cryang659/tunnel-bridge-monitor/123_tunnel/docs/资料包/DX-CT02资料包 20251120_02 模块功能应用指导_SIM卡 说明总结.txt

基础说明：1. 卡类型 --- 30M、100M (使用期限 1 年，使用期限到期后需续费才能继续使用)

停机 机制：1. 当月可用流量用完，会自动停机，需要充值 叠加包，或者等到下个月初，才能正常使用
                 2. 当月可用流量最高300M，超过300M 即使充值 叠加包 也会自动停机，需要等到下个月初，才能正常使用
                 3. 检测IMEI 变更 (例如: 已激活的SIM卡插到其他设备上使用)，会自动停机
                 4. 已激活的SIM卡，连续6个月没有上线，会自动转为停机状态

充值/查询：1. 主套餐 ---   同类型套餐，购买会延长使用时间；不同类型套餐，等原套餐使用时间结束后再生效
                  2. 叠加包 ---  增加当月可用流量，到下个月初自动清零；叠加包充值一般立即生效
                  3. SIM卡状态、流量使用的查询结果，可能会有1~2小时的延迟
                  3. 只能在我们公司的服务号上充值或查询，不提供API接口

沉默期/激活：1. 从供应商发卡算起，有至少6个月的沉默期，到期后卡会自动激活
                     2. 沉默期期间，如SIM卡插入设备上电激活，将提前结束沉默期，开始计算使用时间
                     3. 激活按自然月计时，例如：7月29激活 -> 7月视为第1个计时月，有效期至次年6月30

注销：1. 服务有效期为 1 年，到期后如未续费，账号将进入 3 个月的保留期
          2. 保留期结束后仍未续费，SIM卡会自动注销
