cryang659/tunnel-bridge-monitor/123_bridge/docs/资料包/DX-CT02资料包 20251120_02 模块功能应用指导_SIM卡流量操作示例.pdf

## SIM 卡-微信小程序

## 1.1 进入服务号

1. 微信搜索 “大夏龙雀通信专家” ，选择 “拿样攻略” ，点击 “4G 数传流量充值”

## 1.2 流量查询

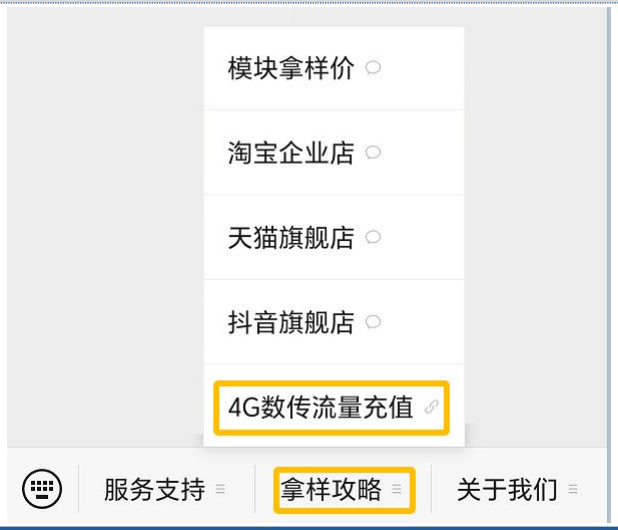
[picture p1: figure]

注：流量查询一般 3h 左右的延迟

## 1. 确认 SIM 卡的 ICCID 号

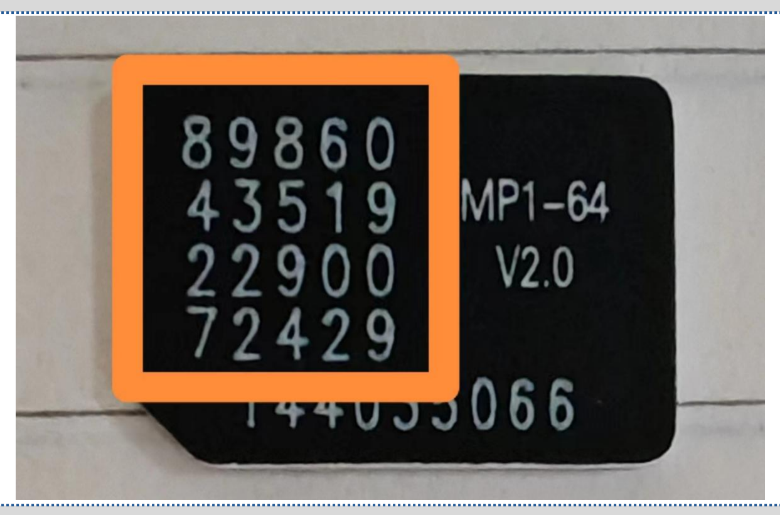
[picture p2: figure]

2. 输入卡号，点击卡号登录：

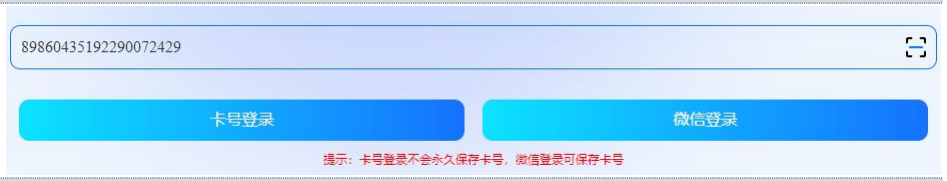
[picture p3: figure]

3. 登录后即可查询流量

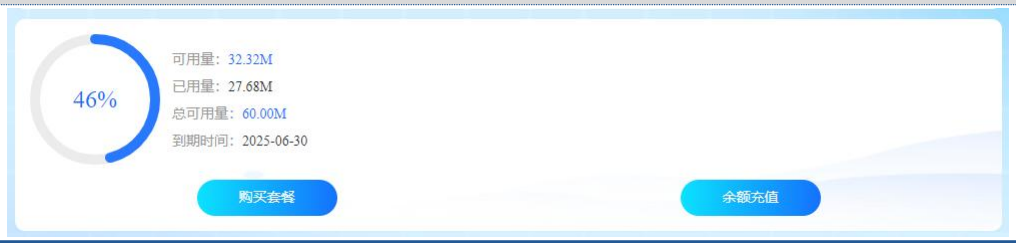
[picture p4: figure]

## 1.3 流量充值

注：充值的叠加包，月末会清零

## 1. 确认 SIM 卡的 ICCID 号

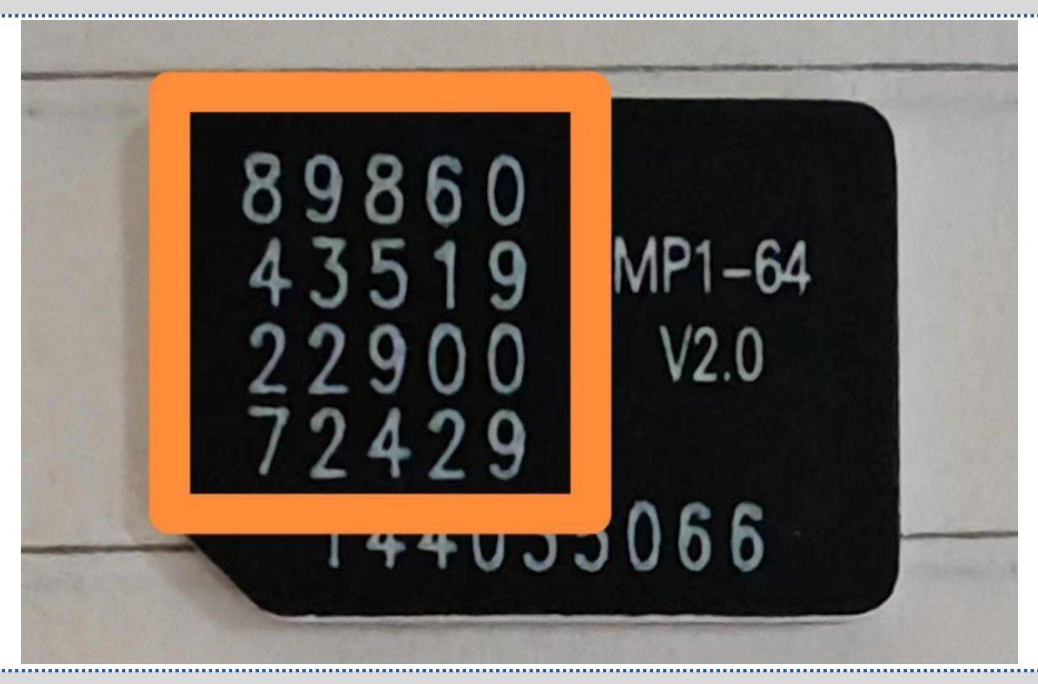
[picture p5: figure]

2. 输入卡号，点击卡号登录，选择购买套餐：

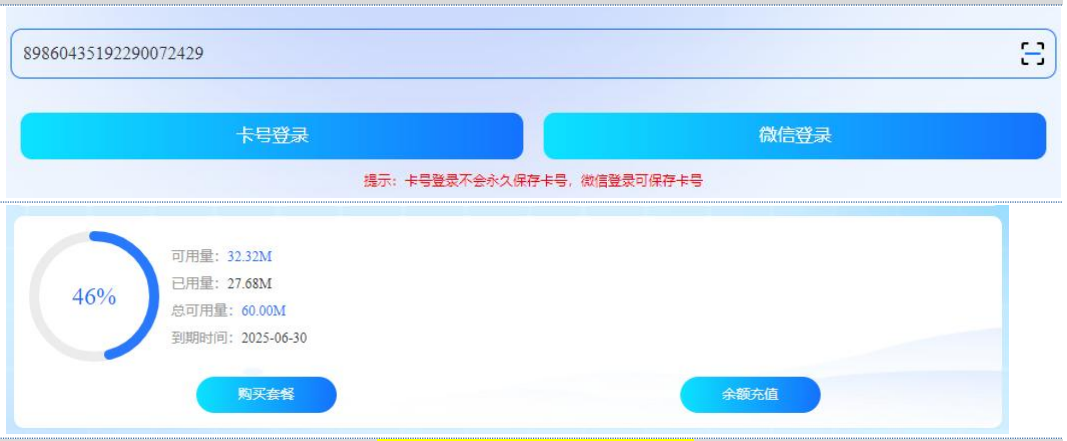
[picture p6: figure]

3. 点击叠加包，选择要的套餐 (注：该叠加包，月末会清零)

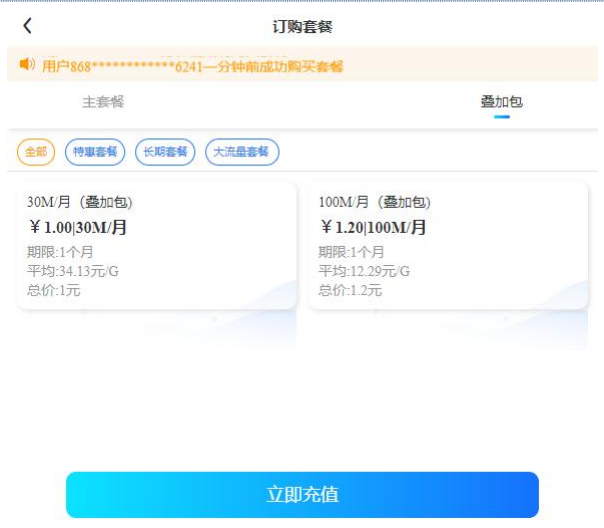
[picture p7: figure]
