cryang659/tunnel-bridge-monitor/123_tunnel/MDK-ARM/build_log.txt

*** Using Compiler 'V6.24', folder: 'C:\Users\21573\app\keil\ARM\ARMCLANG\Bin'
Rebuild target '123'
compiling main.c...
compiling mqtt_client.c...
compiling stm32f1xx_it.c...
compiling sht30.c...
compiling key.c...
compiling st7735.c...
compiling edge_alarm.c...
compiling sensor.c...
compiling wifi_esp8266.c...
compiling soft_i2c.c...
assembling startup_stm32f103xe.s...
compiling vl53l1x.c...
compiling stm32f1xx_hal_msp.c...
compiling sensor_drivers.c...
compiling data_report.c...
compiling menu.c...
compiling stm32f1xx_hal_gpio_ex.c...
compiling stm32f1xx_hal.c...
compiling stm32f1xx_hal_rcc_ex.c...
compiling stm32f1xx_hal_gpio.c...
compiling stm32f1xx_hal_pwr.c...
compiling stm32f1xx_hal_adc_ex.c...
compiling stm32f1xx_hal_rcc.c...
compiling stm32f1xx_hal_cortex.c...
compiling stm32f1xx_hal_flash.c...
compiling stm32f1xx_hal_dma.c...
compiling stm32f1xx_hal_exti.c...
compiling system_stm32f1xx.c...
compiling stm32f1xx_hal_adc.c...
compiling stm32f1xx_hal_flash_ex.c...
compiling stm32f1xx_hal_uart.c...
compiling stm32f1xx_hal_i2c.c...
linking...
Program Size: Code=30150 RO-data=4818 RW-data=76 ZI-data=9036  
FromELF: creating hex file...
"123\123.axf" - 0 Error(s), 0 Warning(s).
Build Time Elapsed:  00:00:03
