cryang659/tunnel-bridge-monitor/(list of files, drawings)

Other design files:
123_bridge/docs/资料包/DX-CT02资料包 20251120_04 模块‌硬件资料_DX-CT01&02_PCB_Footprint&SCH_Part_AD_DX-CT01&02-V1.1_PCB_Footprint_AD.PcbDoc
