cryang659/tunnel-bridge-monitor/123_bridge/123.ioc

Mcu.UserName=STM32F103RCTx
PA0-WKUP.Signal=ADCx_IN0
PA1.Signal=ADCx_IN1
PA2.Signal=USART2_TX
PA3.Signal=USART2_RX
PA4.Signal=ADCx_IN4
PA5.Signal=ADCx_IN5
PA6.Signal=ADCx_IN6
PA7.Signal=ADCx_IN7
PA8.Signal=RCC_MCO
PB6.Signal=I2C1_SCL
PB7.Signal=I2C1_SDA
PD0-OSC_IN.Signal=RCC_OSC_IN
PD1-OSC_OUT.Signal=RCC_OSC_OUT
