cryang659/tunnel-bridge-monitor/123_bridge/Core/Inc/st7735_font.h

/* 8x8 ASCII 字库（0x20-0x7E，95 字符） */
/* 每字符 8 字节，每字节一行，bit7 = 最左像素，Courier New 13pt 生成 */
#ifndef __ST7735_FONT_H
#define __ST7735_FONT_H

const unsigned char FONT8x8[95][8] = {
    {0x00, 0x00, 0x00, 0x00, 0x00, 0x00, 0x00, 0x00},  /*   */
    {0x08, 0x08, 0x08, 0x08, 0x08, 0x00, 0x00, 0x08},  /* ! */
    {0x36, 0x36, 0x24, 0x24, 0x00, 0x00, 0x00, 0x00},  /* \" */
    {0x12, 0x12, 0x24, 0x7E, 0x24, 0x24, 0x7E, 0x24},  /* # */
    {0x08, 0x1C, 0x24, 0x20, 0x18, 0x04, 0x24, 0x38},  /* $ */
    {0x20, 0x50, 0x20, 0x0C, 0x70, 0x08, 0x14, 0x08},  /* % */
    {0x0E, 0x10, 0x10, 0x18, 0x2A, 0x24, 0x1E, 0x00},  /* & */
    {0x10, 0x10, 0x10, 0x10, 0x00, 0x00, 0x00, 0x00},  /* ' */
    {0x04, 0x04, 0x08, 0x08, 0x08, 0x08, 0x08, 0x08},  /* ( */
    {0x20, 0x20, 0x10, 0x10, 0x10, 0x10, 0x10, 0x10},  /* ) */
    {0x08, 0x3E, 0x08, 0x14, 0x14, 0x00, 0x00, 0x00},  /* * */
    {0x08, 0x08, 0x08, 0x7F, 0x08, 0x08, 0x08, 0x00},  /* + */
    {0x18, 0x10, 0x30, 0x20, 0x00, 0x00, 0x00, 0x00},  /* , */
    {0x7E, 0x00, 0x00, 0x00, 0x00, 0x00, 0x00, 0x00},  /* - */
    {0x00, 0x00, 0x00, 0x00, 0x00, 0x00, 0x18, 0x18},  /* . */
    {0x04, 0x04, 0x08, 0x08, 0x10, 0x10, 0x20, 0x20},  /* / */
    {0x3C, 0x42, 0x42, 0x42, 0x42, 0x42, 0x42, 0x3C},  /* 0 */
    {0x08, 0x38, 0x08, 0x08, 0x08, 0x08, 0x08, 0x3E},  /* 1 */
    {0x38, 0x44, 0x04, 0x08, 0x10, 0x20, 0x44, 0x7C},  /* 2 */
    {0x38, 0x44, 0x04, 0x18, 0x04, 0x04, 0x44, 0x38},  /* 3 */
    {0x0C, 0x14, 0x24, 0x24, 0x7E, 0x04, 0x04, 0x0E},  /* 4 */
    {0x3E, 0x20, 0x20, 0x3C, 0x02, 0x02, 0x42, 0x3C},  /* 5 */
    {0x0E, 0x10, 0x20, 0x3C, 0x22, 0x22, 0x22, 0x1C},  /* 6 */
    {0x7E, 0x42, 0x02, 0x04, 0x04, 0x08, 0x08, 0x08},  /* 7 */
    {0x3C, 0x42, 0x42, 0x3C, 0x42, 0x42, 0x42, 0x3C},  /* 8 */
    {0x3C, 0x42, 0x42, 0x42, 0x3E, 0x02, 0x04, 0x78},  /* 9 */
    {0x18, 0x18, 0x00, 0x00, 0x18, 0x18, 0x00, 0x00},  /* : */
    {0x18, 0x18, 0x00, 0x00, 0x18, 0x30, 0x20, 0x00},  /* ; */
    {0x02, 0x0C, 0x10, 0x60, 0x10, 0x0C, 0x02, 0x00},  /* < */
    {0x7E, 0x00, 0x7E, 0x00, 0x00, 0x00, 0x00, 0x00},  /* = */
    {0x40, 0x30, 0x08, 0x06, 0x08, 0x30, 0x40, 0x00},  /* > */
    {0x1C, 0x22, 0x02, 0x02, 0x04, 0x08, 0x00, 0x18},  /* ? */
    {0x38, 0x44, 0x44, 0x4C, 0x54, 0x54, 0x4C, 0x40},  /* @ */
    {0x18, 0x08, 0x14, 0x14, 0x14, 0x1C, 0x22, 0x77},  /* A */
    {0x7C, 0x22, 0x22, 0x3C, 0x22, 0x22, 0x22, 0x7C},  /* B */
    {0x1E, 0x22, 0x40, 0x40, 0x40, 0x40, 0x22, 0x1C},  /* C */
    {0x78, 0x24, 0x22, 0x22, 0x22, 0x22, 0x24, 0x78},  /* D */
    {0x7E, 0x22, 0x28, 0x38, 0x28, 0x20, 0x22, 0x7E},  /* E */
    {0x7E, 0x22, 0x28, 0x38, 0x28, 0x20, 0x20, 0x70},  /* F */
    {0x1E, 0x22, 0x40, 0x40, 0x47, 0x42, 0x22, 0x1C},  /* G */
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
};

#endif /* __ST7735_FONT_H */
